kulovac/tuner-pedal/README.md

# Tuner Pedal

A tuner pedal project using an STM32 microcontroller with the CMSIS-DSP library
