kulovac/tuner-pedal/pcb/components/3dmodels/pcm1802.step

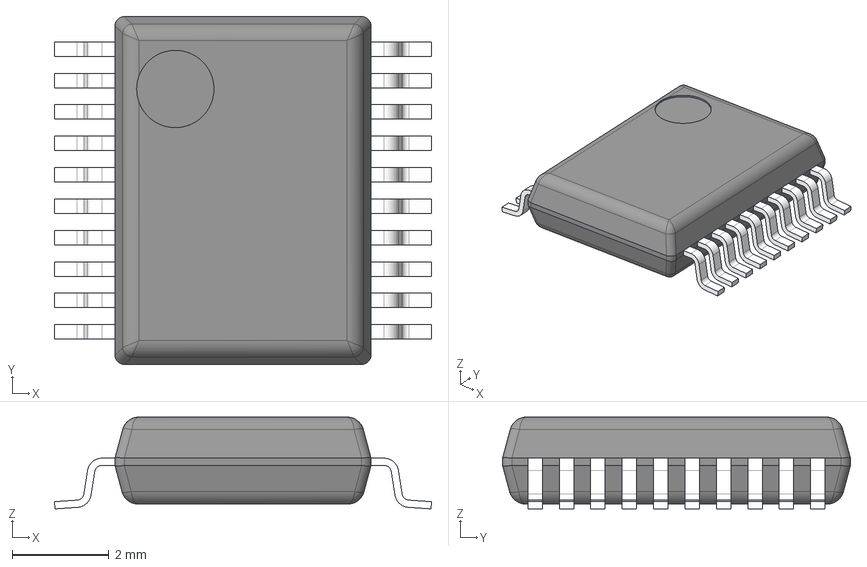
[picture p1: CAD file, 2025-06-20]
pcb/components/3dmodels/pcm1802.step
7.80 x 7.20 x 1.90 mm
BODY-SSOP
LEAD-SSOP x 20
PIN1
