kulovac/tuner-pedal/pcb/components/3dmodels/ECS-2520MVLC-081.92-BN-TR.step

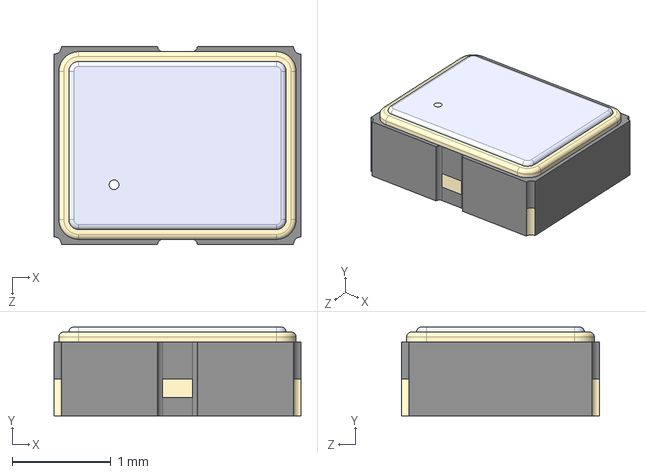
[picture p2: CAD file, 2025-06-20]
pcb/components/3dmodels/ECS-2520MVLC-081.92-BN-TR.step
2.50 x 0.9 x 2.00 mm
