kulovac/tuner-pedal/pcb/tuner_pedal.kicad_pcb

## KiCad design pcb/tuner_pedal.kicad_pcb (2025-07-28)

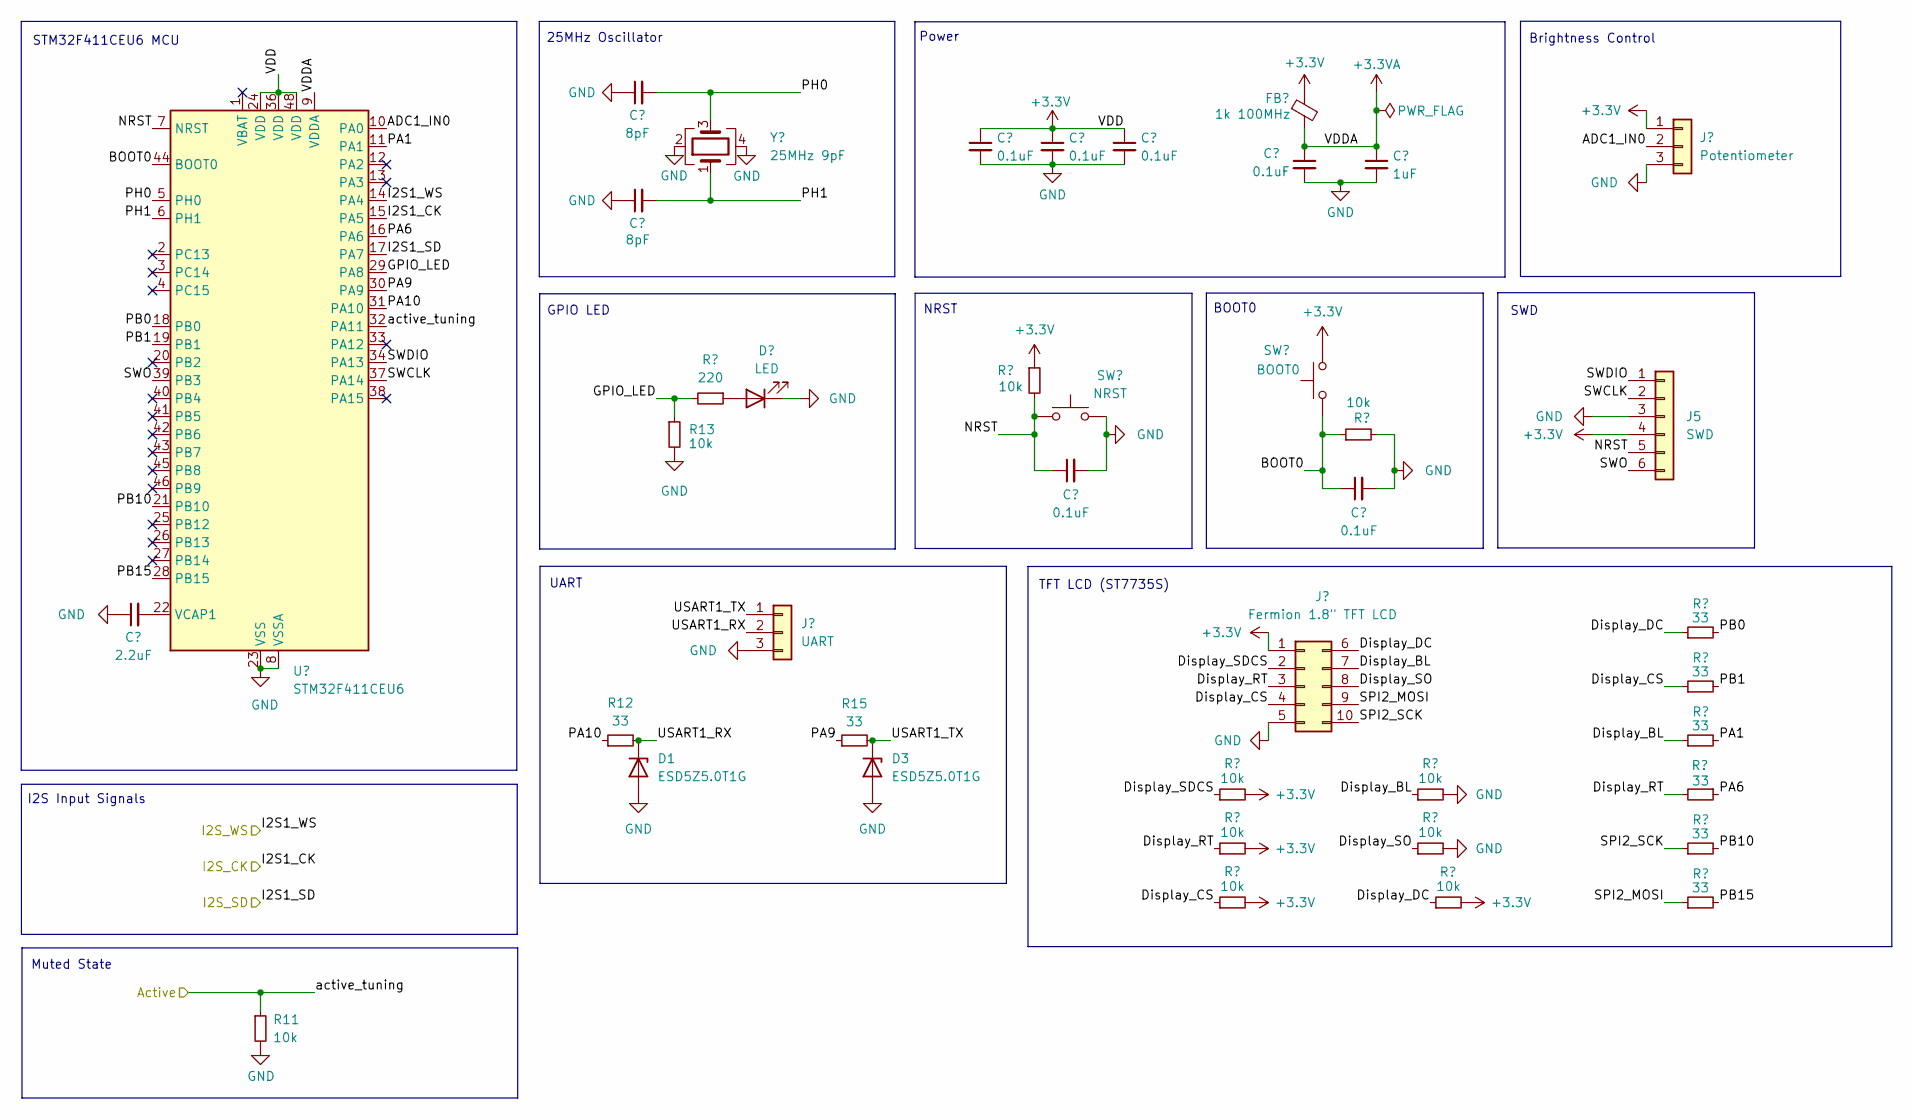
[picture p3: schematic mcu.kicad_sch]

Parts:
C22: 2.2uF; C_0805_2012Metric; MPN CL21B225KAFNNNE; LCSC C19110
C23, C24: 8pF; C_0402_1005Metric; MPN 0402CG8R0C500NT; LCSC C1578
C25, C26, C27, C28, C29, C30: 0.1uF; C_0402_1005Metric; MPN CL05B104KO5NNNC; LCSC C1525
C31: 1uF; C_0805_2012Metric; MPN CL21B105KAFNFNE; LCSC C1712
D1, D3: ESD5Z5.0T1G; D_SOD-523; MPN ESD5Z5.0T1G; LCSC C82044
D2: LED; LED_0603_1608Metric; MPN KT-0603R; LCSC C2286
FB1: 1k 100MHz; L_1806_4516Metric; MPN BLM41PG102SN1L; LCSC C88999
J3: UART; PinSocket_1x03_P2.54mm_Vertical
J4: Fermion 1.8" TFT LCD; PinHeader_2x05_P2.54mm_Vertical
J5: SWD; PinHeader_1x06_P2.54mm_Vertical
J6: Potentiometer; PinSocket_1x03_P2.54mm_Vertical
R11, R13, R16, R17, R18, R19, R20, R21, R22, R23: 10k; R_0603_1608Metric; MPN RC0603FR-0710KL; LCSC C98220
R12, R15, R24, R25, R26, R27, R28, R29: 33; R_0603_1608Metric; MPN RC0603FR-0733RL; LCSC C108661
R14: 220; R_0603_1608Metric; MPN RC0603FR-07220RL; LCSC C107696
SW1: NRST; SW_Push_1P1T_NO_6x6mm_H9.5mm; MPN TL3301AF160QG; LCSC C273519
SW2: BOOT0; SW_Push_1P1T_NO_6x6mm_H9.5mm; MPN TL3301AF160QG; LCSC C273519
U4: STM32F411CEU6; QFN-48-1EP_7x7mm_P0.5mm_EP5.6x5.6mm; MPN STM32F411CEU6; LCSC C60420
Y1: 25MHz 9pF; Crystal_SMD_3225-4Pin_3.2x2.5mm; MPN 3225-25-9-10-10/A; LCSC C2981679

Connections:
+3.3V: C25.1, C26.1, C28.1, FB1.1, J4.1, J5.4, J6.1, R16.1, R17.2, R18.2, R19.2, R23.2, SW2.2, U4.24 (VDD), U4.36 (VDD), U4.48 (VDD); also elsewhere on the board
+3.3VA: C29.1, C31.1, FB1.2, U4.9 (VDDA)
/MCU/ADC1_IN0: J6.2, U4.10 (PA0)
/MCU/BOOT0: C30.1, R20.1, SW2.1, U4.44 (BOOT0)
/MCU/Display_BL: J4.7, R21.1, R24.1
/MCU/Display_CS: J4.4, R19.1, R25.1
/MCU/Display_DC: J4.6, R23.1, R26.1
/MCU/Display_RT: J4.3, R18.1, R28.2
/MCU/Display_SDCS: J4.2, R17.1
/MCU/Display_SO: J4.8, R22.1
/MCU/GPIO_LED: R13.1, R14.2, U4.29 (PA8)
/MCU/I2S1_CK: U4.15 (PA5); also elsewhere on the board
/MCU/I2S1_SD: U4.17 (PA7); also elsewhere on the board
/MCU/I2S1_WS: U4.14 (PA4); also elsewhere on the board
/MCU/NRST: C27.1, J5.5, R16.2, SW1.1, U4.7 (NRST)
/MCU/PA1: R24.2, U4.11 (PA1)
/MCU/PA6: R28.1, U4.16 (PA6)
/MCU/PA9: R15.1, U4.30 (PA9)
/MCU/PA10: R12.1, U4.31 (PA10)
/MCU/PB0: R26.2, U4.18 (PB0)
/MCU/PB1: R25.2, U4.19 (PB1)
/MCU/PB10: R27.2, U4.21 (PB10)
/MCU/PB15: R29.2, U4.28 (PB15)
/MCU/PH0: C23.2, U4.5 (PH0), Y1.3
/MCU/PH1: C24.2, U4.6 (PH1), Y1.1
/MCU/SPI2_MOSI: J4.9, R29.1
/MCU/SPI2_SCK: J4.10, R27.1
/MCU/SWCLK: J5.2, U4.37 (PA14)
/MCU/SWDIO: J5.1, U4.34 (PA13)
/MCU/SWO: J5.6, U4.39 (PB3)
/MCU/USART1_RX: D1.1 (K), J3.2, R12.2
/MCU/USART1_TX: D3.1 (K), J3.1, R15.2
/MCU/active_tuning: R11.1, U4.32 (PA11); also elsewhere on the board
GND: C22.1, C23.1, C24.1, C25.2, C26.2, C27.2, C28.2, C29.2, C30.2, C31.2, D1.2 (A), D2.1 (K), D3.2 (A), J3.3, J4.5, J5.3, J6.3, R11.2, R13.2, R20.2, R21.2, R22.2, SW1.2, U4.8 (VSSA), U4.23 (VSS), U4.35 (VSS), U4.47 (VSS), U4.49 (VSS), Y1.2, Y1.4; also elsewhere on the board
unnamed: D2.2 (A), R14.1
unnamed: C22.2, U4.22 (VCAP1)

Notes on the sheet:
BOOT0
Muted State
NRST
TFT LCD (ST7735S)
GPIO LED
25MHz Oscillator
STM32F411CEU6 MCU
UART
SWD
Brightness Control
Power
I2S Input Signals

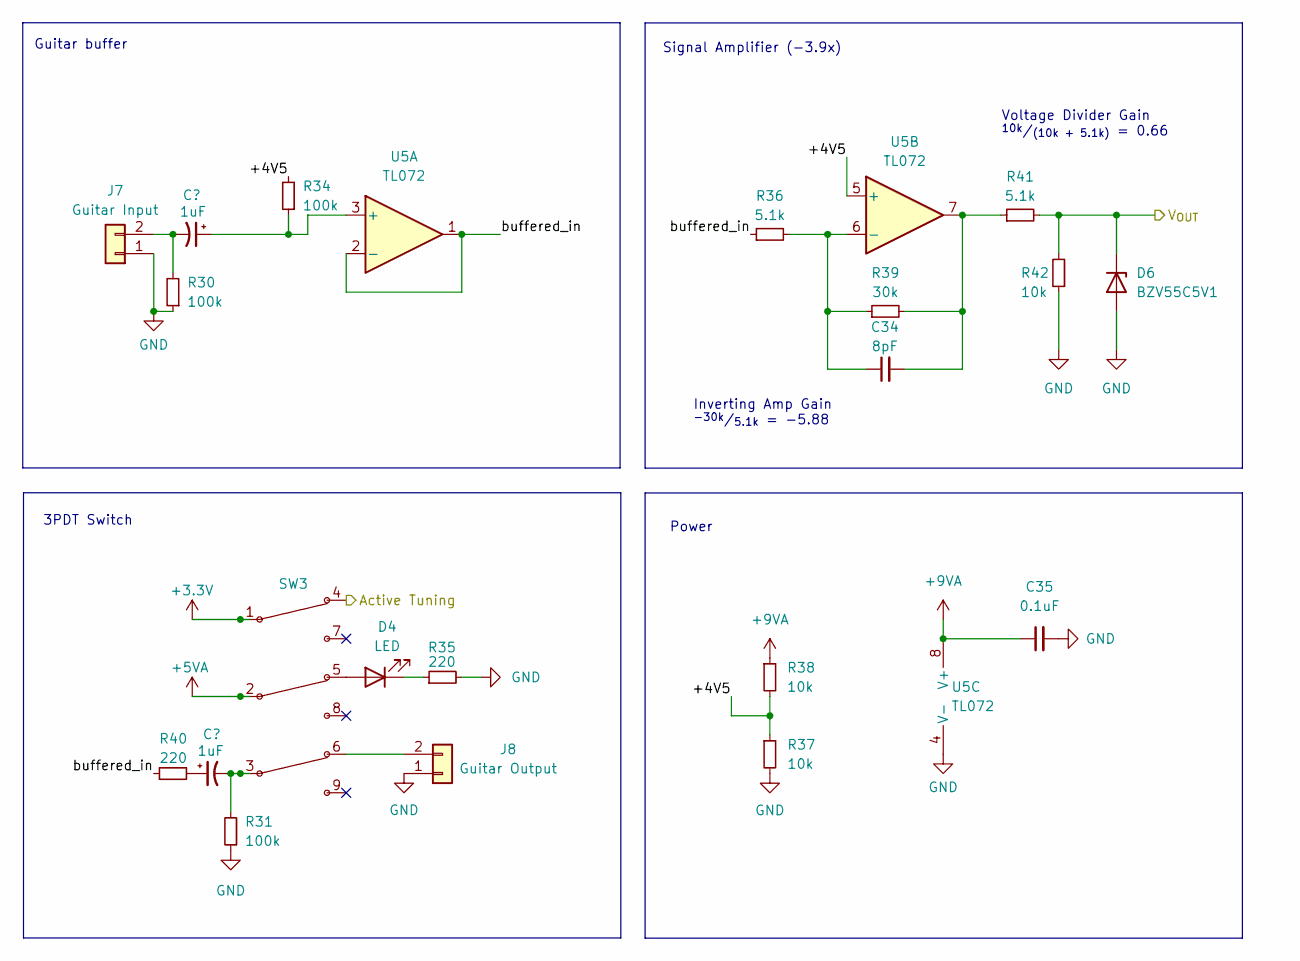
[picture p4: schematic analog_in.kicad_sch]

Parts:
C32, C33: 1uF; C_0805_2012Metric; MPN CL21B105KAFNFNE; LCSC C1712
C34: 8pF; C_0402_1005Metric; MPN 0402CG8R0C500NT; LCSC C1578
C35: 0.1uF; C_0402_1005Metric; MPN CL05B104KO5NNNC; LCSC C1525
D4: LED; PinHeader_1x02_P2.54mm_Vertical
D6: BZV55C5V1; D_MiniMELF; MPN BZV55B5V1; LCSC C545327
J7: Guitar Input; PinSocket_1x02_P2.54mm_Vertical
J8: Guitar Output; PinSocket_1x02_P2.54mm_Vertical
R30, R31, R34: 100k; R_0603_1608Metric; MPN RC0603FR-07100KL; LCSC C14675
R35, R40: 220; R_0603_1608Metric; MPN RC0603FR-07220RL; LCSC C107696
R36: 5.1k; R_Axial_DIN0207_L6.3mm_D2.5mm_P7.62mm_Horizontal; MPN MFR-25FTE52-5K1; LCSC C173033
R37, R38, R42: 10k; R_0603_1608Metric; MPN RC0603FR-0710KL; LCSC C98220
R39: 30k; R_Axial_DIN0207_L6.3mm_D2.5mm_P7.62mm_Horizontal; MPN MFR-25FTE52-30K; LCSC C173003
R41: 5.1k; R_0603_1608Metric; MPN RC0603FR-075K1L; LCSC C105580
SW3: PinHeader_2x03_P2.54mm_Vertical
U5: TL072; DIP-8_W7.62mm_Socket

Connections:
+3.3V: SW3.1; also elsewhere on the board
+5VA: SW3.2; also elsewhere on the board
+9VA: C35.1, R38.1, U5.8 (V+); also elsewhere on the board
/ADC/V_{IN}: D6.1 (K), R41.2, R42.2; also elsewhere on the board
/Analog Signal/+4V5: R34.2, R37.1, R38.2, U5.5 (+); also elsewhere on the board
/Analog Signal/buffered_in: R36.1, R40.1, U5.1, U5.2 (-)
/MCU/active_tuning: SW3.4; also elsewhere on the board
GND: C35.2, D6.2 (A), J7.1, J8.1, R30.1, R31.1, R35.2, R37.2, R42.1, U5.4 (V-); also elsewhere on the board
unnamed: C33.1, R40.2
unnamed: C33.2, R31.2, SW3.3
unnamed: C34.2, R39.2, R41.1, U5.7
unnamed: D4.2 (A), SW3.5
unnamed: D4.1 (K), R35.1
unnamed: C32.2, J7.2, R30.2
unnamed: J8.2, SW3.6
unnamed: C32.1, R34.1, U5.3 (+)
unnamed: C34.1, R36.2, R39.1, U5.6 (-)

Notes on the sheet:
Power
3PDT Switch
Inverting Amp Gain ^{-30k}/_{5.1k} = -5.88
Voltage Divider Gain ^{10k}/_{(10k + 5.1k)} = 0.66
Guitar buffer
Signal Amplifier (-3.9x)

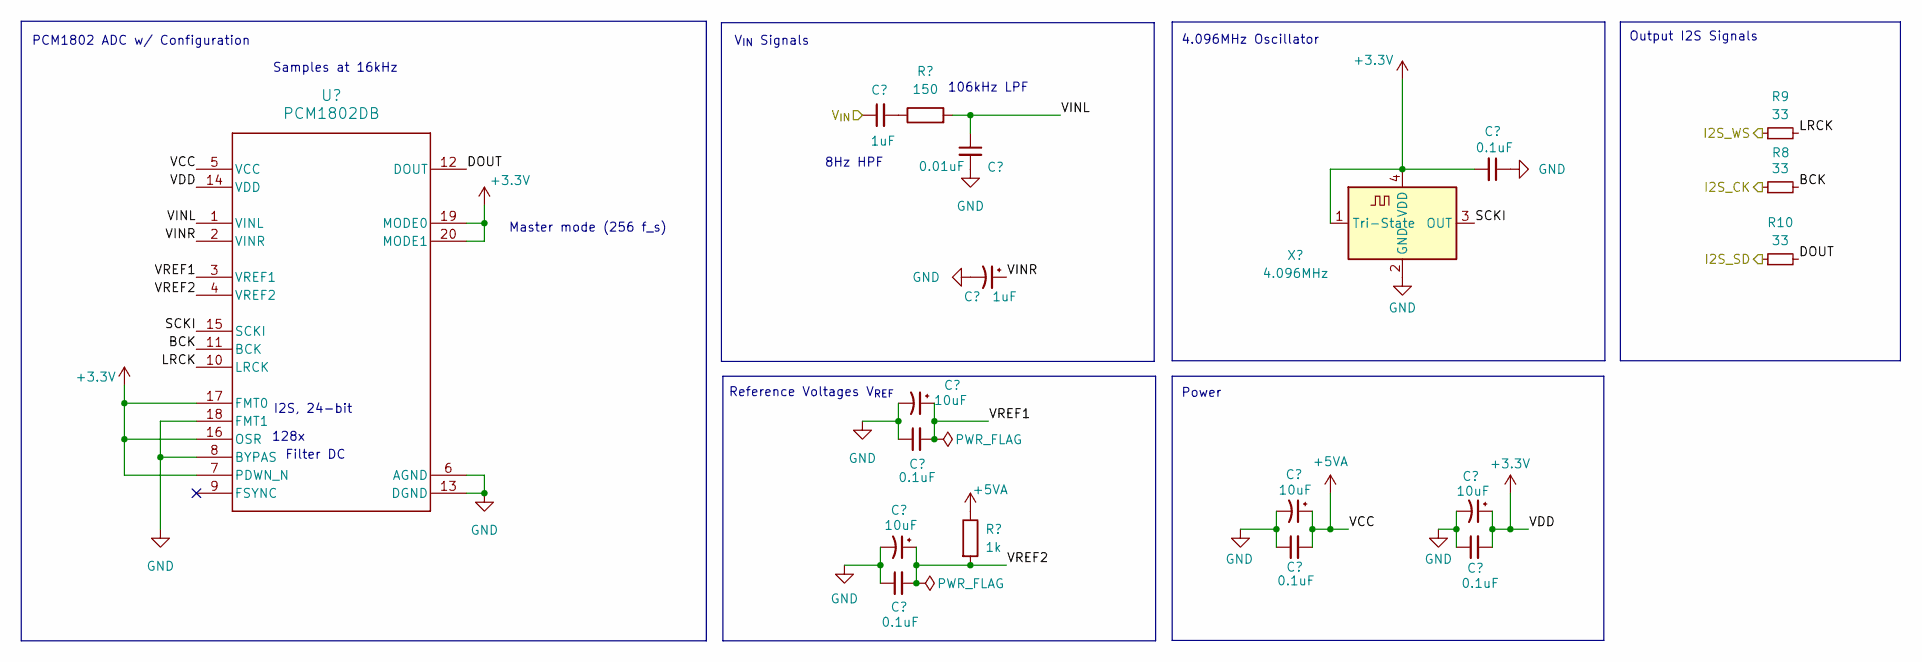
[picture p5: schematic adc.kicad_sch]

Parts:
C10, C16: 1uF; C_0805_2012Metric; MPN CL21B105KAFNFNE; LCSC C1712
C11, C13, C17, C20: 10uF; CP_EIA-3216-18_Kemet-A; MPN TAJA106K010RNJ; LCSC C7177
C12, C14, C18, C19, C21: 0.1uF; C_0402_1005Metric; MPN CL05B104KO5NNNC; LCSC C1525
C15: 0.01uF; C_0603_1608Metric; MPN CL10C100JB8NNNC; LCSC C1634
R6: 150; R_0603_1608Metric; MPN RC0603FR-07150RL; LCSC C114608
R7: 1k; R_0603_1608Metric; MPN RC0603JR-071KL; LCSC C14676
R8, R9, R10: 33; R_0603_1608Metric; MPN RC0603FR-0733RL; LCSC C108661
U3: PCM1802DB; SSOP-20_5.3x7.2mm_P0.65mm; MPN PCM1802DB; LCSC C1520787
X1: 4.096MHz; Crystal_SMD_3225-4Pin_3.2x2.5mm; MPN OT32254.096MJBA4SL; LCSC C2831395

Connections:
+3.3V: C19.2, C20.1, C21.2, U3.7 (PDWN_N), U3.14 (VDD), U3.16 (OSR), U3.17 (FMT0), U3.19 (MODE0), U3.20 (MODE1), X1.1 (Tri-State), X1.4 (VDD); also elsewhere on the board
+5VA: C17.1, C18.2, R7.1, U3.5 (VCC); also elsewhere on the board
/ADC/BCK: R8.2, U3.11 (BCK)
/ADC/DOUT: R10.2, U3.12 (DOUT)
/ADC/LRCK: R9.2, U3.10 (LRCK)
/ADC/SCKI: U3.15 (SCKI), X1.3 (OUT)
/ADC/VINL: C15.1, R6.2, U3.1 (VINL)
/ADC/VINR: C16.1, U3.2 (VINR)
/ADC/VREF1: C13.1, C14.2, U3.3 (VREF1)
/ADC/VREF2: C11.1, C12.2, R7.2, U3.4 (VREF2)
/ADC/V_{IN}: C10.1; also elsewhere on the board
/MCU/I2S1_CK: R8.1; also elsewhere on the board
/MCU/I2S1_SD: R10.1; also elsewhere on the board
/MCU/I2S1_WS: R9.1; also elsewhere on the board
GND: C11.2, C12.1, C13.2, C14.1, C15.2, C16.2, C17.2, C18.1, C19.1, C20.2, C21.1, U3.6 (AGND), U3.8 (BYPAS), U3.13 (DGND), U3.18 (FMT1), X1.2 (GND); also elsewhere on the board
unnamed: C10.2, R6.1

Notes on the sheet:
I2S, 24-bit
Master mode (256 f_s)
4.096MHz Oscillator
PCM1802 ADC w/ Configuration
Output I2S Signals
Reference Voltages V_{REF}
Samples at 16kHz
8Hz HPF
Filter DC
106kHz LPF
128x
Power
V_{IN} Signals

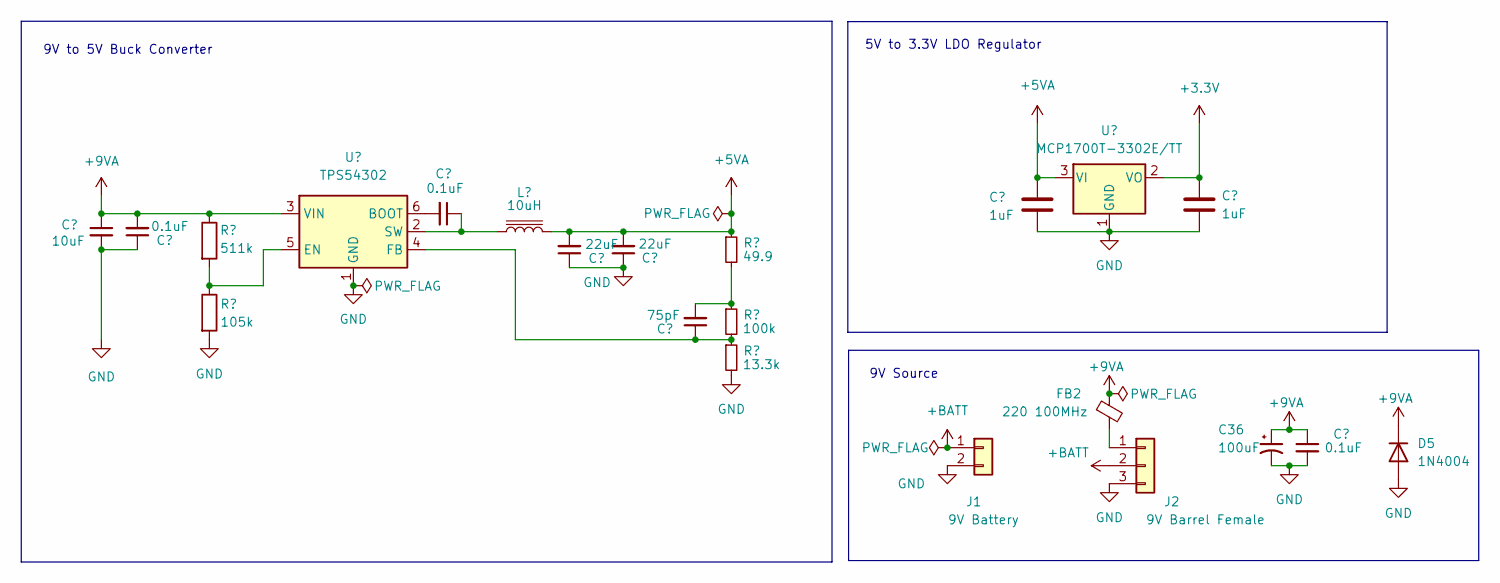
[picture p6: schematic power.kicad_sch]

Parts:
C1: 10uF; C_1206_3216Metric; MPN CC1206KKX7R8BB106; LCSC C70462
C2, C3, C9: 0.1uF; C_0402_1005Metric; MPN CL05B104KO5NNNC; LCSC C1525
C4, C5: 22uF; C_1206_3216Metric; MPN GRM31CR71A226KE15L; LCSC C91604
C6: 75pF; C_0402_1005Metric; MPN CC0402JRNPO9BN750; LCSC C107010
C7, C8: 1uF; C_0805_2012Metric; MPN CL21B105KAFNFNE; LCSC C1712
C36: 100uF; CP_Elec_6.3x5.4; MPN RVT100UF16V67RV0016; LCSC C2887276
D5: 1N4004; D_DO-41_SOD81_P10.16mm_Horizontal; MPN 1N4004; LCSC C3058
FB2: 220 100MHz; L_0603_1608Metric; MPN BLM18PG221SN1D; LCSC C80165
J1: 9V Battery; PinSocket_1x02_P2.54mm_Vertical
J2: 9V Barrel Female; PinHeader_1x03_P2.54mm_Vertical
L1: 10uH; L_6.3x6.3_H3; MPN PNLS6045-100M 10UH; LCSC C2849537
R1: 511k; R_0603_1608Metric; MPN RC0603FR-07511KL; LCSC C188257
R2: 105k; R_0603_1608Metric; MPN RC0603FR-07105KL; LCSC C141685
R3: 49.9; R_0603_1608Metric; MPN RC0603FR-0749R9L; LCSC C114625
R4: 100k; R_0603_1608Metric; MPN RC0603FR-07100KL; LCSC C14675
R5: 13.3k; R_0603_1608Metric; MPN RC0603FR-0713K3L; LCSC C185373
U1: TPS54302; SOT-23-6; MPN TPS54302DDCR; LCSC C311983
U2: MCP1700T-3302E/TT; SOT-23-3; MPN MCP1700T-3302E/TT; LCSC C39051

Connections:
+3.3V: C8.1, U2.2 (VO); also elsewhere on the board
+5VA: C4.2, C5.2, C7.1, L1.2, R3.1, U2.3 (VI); also elsewhere on the board
+9VA: C1.1, C2.2, C9.1, C36.1, D5.1 (K), FB2.1, R1.1, U1.3 (VIN); also elsewhere on the board
+BATT: J1.1, J2.2
GND: C1.2, C2.1, C4.1, C5.1, C7.2, C8.2, C9.2, C36.2, D5.2 (A), J1.2, J2.3, R2.2, R5.2, U1.1 (GND), U2.1 (GND); also elsewhere on the board
unnamed: C6.2, R3.2, R4.1
unnamed: FB2.2, J2.1
unnamed: C3.2, U1.6 (BOOT)
unnamed: R1.2, R2.1, U1.5 (EN)
unnamed: C6.1, R4.2, R5.1, U1.4 (FB)
unnamed: C3.1, L1.1, U1.2 (SW)

Notes on the sheet:
9V Source
5V to 3.3V LDO Regulator
9V to 5V Buck Converter

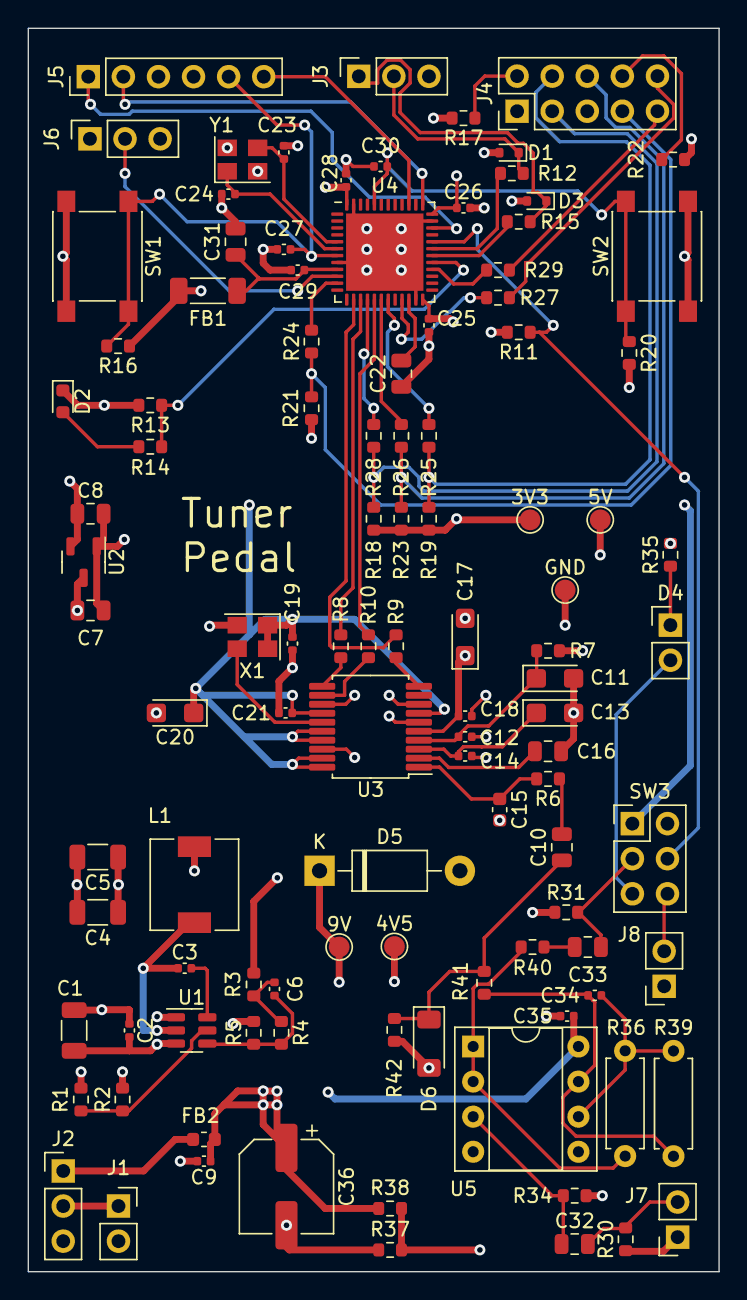
[picture p7: board tuner_pedal.kicad_pcb from above]

Board: 4 copper layers, 50.0 x 90.0 mm, 108 parts (0 on the bottom side), 66 nets.

Other parts of the board:
3V3, 4V5, 5V, 9V: TestPoint_Pad_D1.5mm
GND: TestPoint_Pad_D1.5mm

Their connections:
+3.3V: 3V3.1; also elsewhere on the board
+5VA: 5V.1; also elsewhere on the board
+9VA: 9V.1; also elsewhere on the board
/Analog Signal/+4V5: 4V5.1; also elsewhere on the board
GND: GND.1; also elsewhere on the board
