kulovac/tuner-pedal/firmware/src/log.c

#include "log.h"
#include "bsp.h"
#include "stm32f4xx_ll_bus.h"
#include "stm32f4xx_ll_gpio.h"
#include "stm32f4xx_ll_usart.h"
#include <stdarg.h>
#include <stdio.h>

#if LOG_LEVEL != LOG_LEVEL_NONE

static void usart_puts(const char *);

void init_logger(void) {
    LL_APB2_GRP1_EnableClock(LL_APB2_GRP1_PERIPH_USART1);

    LL_GPIO_InitTypeDef tx_pin = {.Pin = LOGGER_TX_PIN,
                                  .Mode = LL_GPIO_MODE_ALTERNATE,
                                  .Speed = LL_GPIO_SPEED_FREQ_HIGH,
                                  .OutputType = LL_GPIO_OUTPUT_PUSHPULL,
                                  .Pull = LL_GPIO_PULL_UP,
                                  .Alternate = LOGGER_TX_AF};
    LL_GPIO_Init(LOGGER_TX_PORT, &tx_pin);

    LL_USART_InitTypeDef logger = {.BaudRate = 115200,
                                   .DataWidth = LL_USART_DATAWIDTH_8B,
                                   .StopBits = LL_USART_STOPBITS_1,
                                   .Parity = LL_USART_PARITY_NONE,
                                   .TransferDirection = LL_USART_DIRECTION_TX,
                                   .HardwareFlowControl =
                                       LL_USART_HWCONTROL_NONE,
                                   .OverSampling = LL_USART_OVERSAMPLING_8};

    LL_USART_Init(LOGGER_USART, &logger);
    LL_USART_Enable(LOGGER_USART);
}

void usart_printf(const char *str, ...) {
    char formatted[LOG_BUFFER_SIZE];
    va_list args;

    va_start(args, str);
    vsnprintf(formatted, LOG_BUFFER_SIZE, str, args);
    va_end(args);

    usart_puts(formatted);
}

static void usart_puts(const char *str) {
    while (*str != '\0') {
        while (!LL_USART_IsActiveFlag_TXE(LOGGER_USART))
            ;
        LL_USART_TransmitData8(LOGGER_USART, *str++);
    }
}

#endif
