kulovac/tuner-pedal/(commit log)

2025-06-20 Updated gitignore for KiCAD
    [ABLS-8.192MHZ-B2-T.step, ECS-2520MVLC-081.92-BN-TR.step, pcm1802.step]
2025-06-20 Starting tuner pedal schematic with ADC
    [tuner_pedal.kicad_pcb, tuner_pedal.kicad_sch]
2025-06-20 Added 5->3.3V LDO
    [tuner_pedal.kicad_sch]
2025-06-20 Added 9V->5V buck converter
    [tuner_pedal.kicad_sch]
2025-06-20 added githubs gitignore for kicad
2025-06-20 added AC coupling cap to unused V_inR
    [tuner_pedal.kicad_sch]
2025-06-20 Added crystal oscillators to stm32
    [tuner_pedal.kicad_sch]
2025-06-20 Deleted unused component
    [ABLS-8.192MHZ-B2-T.step]
2025-06-20 Removed RTC crystal
    [tuner_pedal.kicad_sch]
2025-06-20 Connected stm32 to 3V3
    [tuner_pedal.kicad_sch]
2025-06-20 Added SWD header
    [tuner_pedal.kicad_sch]
2025-06-20 Defined which pins will be used on the stm32
    [tuner_pedal.kicad_sch]
2025-06-20 Defined headers for each interface
    [tuner_pedal.kicad_sch]
2025-06-21 Added GPIO attached LED for debugging purposes
    [tuner_pedal.kicad_sch]
2025-06-21 Made FSYNC floating
    [tuner_pedal.kicad_sch]
2025-06-21 Added NRST and BOOT0 buttons
    [tuner_pedal.kicad_sch]
2025-06-21 Added pull-ups/downs and series termination to LCD
    [tuner_pedal.kicad_sch]
2025-06-23 Added pot pins
    [tuner_pedal.kicad_sch]
2025-06-23 Created a power sheet
    [power.kicad_sch, tuner_pedal.kicad_sch]
2025-06-23 Added filtering cap to 9V barrel
    [power.kicad_sch]
2025-06-24 Removed power hierarchy labels
    [power.kicad_sch]
2025-06-24 Made sheet for ADC
    [adc.kicad_sch, tuner_pedal.kicad_sch]
2025-06-24 Made MCU sheet
    [mcu.kicad_sch, tuner_pedal.kicad_sch]
2025-06-24 Connected SWO pin
    [mcu.kicad_sch]
2025-06-25 Changed the LPF to 106 kHz cutoff
    [adc.kicad_sch]
2025-06-27 Created 3PDT footswitch schematic symbol
2025-06-27 Created analog frontend
    [analog_in.kicad_sch]
2025-06-27 Changed cap to nonpolarized to account for analog_in biasing scheme
    [adc.kicad_sch]
2025-06-27 Added input GPIO to check muted state
    [mcu.kicad_sch]
2025-06-27 Brought in analog frontend
    [tuner_pedal.kicad_sch]
2025-06-27 Fixed I/O direction on hierarchy labels
    [adc.kicad_sch, analog_in.kicad_sch, mcu.kicad_sch, tuner_pedal.kicad_sch]
2025-06-27 Reordered components
    [adc.kicad_sch, analog_in.kicad_sch, mcu.kicad_sch, power.kicad_sch]
2025-06-27 Connected VDD cap to GND
    [adc.kicad_sch]
2025-06-27 actually connect net
    [analog_in.kicad_sch]
2025-06-27 Adding safety to output jack signal path
    [analog_in.kicad_sch]
2025-06-27 Attached backlight to timer capable pin
    [mcu.kicad_sch]
2025-06-28 Assigned footprints and jlcpcb part number to all components
    [adc.kicad_sch, analog_in.kicad_sch, mcu.kicad_sch, power.kicad_sch]
2025-06-29 Added correct datasheet to pcm1802 symbol
    [adc.kicad_sch]
2025-06-29 Changed 10k inverting amp resistor to THT for easy swapping
    [analog_in.kicad_sch]
2025-06-29 Changed op amp supply to 9V to make sure clipping doesn't occur
    [analog_in.kicad_sch]
2025-06-29 Added better filtering for 9V supply
    [power.kicad_sch]
2025-06-29 ERC fixes
    [adc.kicad_sch, analog_in.kicad_sch, mcu.kicad_sch, power.kicad_sch, tuner_pedal.kicad_sch]
2025-06-29 Starting PCB layout
    [adc.kicad_sch, analog_in.kicad_sch, mcu.kicad_sch, power.kicad_sch, tuner_pedal.kicad_pcb]
2025-06-30 Added Analog in signal and 9V to 5V buck converter
    [analog_in.kicad_sch, power.kicad_sch, tuner_pedal.kicad_pcb]
2025-07-01 First revision of the pcb layout
    [adc.kicad_sch, analog_in.kicad_sch, mcu.kicad_sch, power.kicad_sch, tuner_pedal.kicad_pcb]
2025-07-02 trying to isolate analog from noise sources
    [analog_in.kicad_sch, tuner_pedal.kicad_pcb]
2025-07-02 Moved LED to make soldering a bit easier
    [tuner_pedal.kicad_pcb]
2025-07-11 Updated gitignore for C and STM32
2025-07-11 cloned 'https://github.com/ARM-software/CMSIS-DSP.git'
2025-07-28 Lowered resistor values and added protection diode
    [analog_in.kicad_sch, power.kicad_sch, tuner_pedal.kicad_pcb]
2026-07-12 Basic uart logging for dev work
2026-07-12 Setup stm32f4 driver boilerplate
2026-07-12 led on!
2026-07-12 now a blinking led!
2026-07-12 Basic uart test
2026-07-12 uart based logger
2026-07-25 Added initialization for i2s device (pre dma)
2026-07-25 Enable I2S device
2026-07-25 One shot test getting 512 L and R samples
2026-07-25 add missing `const` modifier
    [dsp.c]
2026-08-08 Setup DMA to be used with the display
2026-08-08 Display no longer bottlenecks the system
    [main.c]
2026-08-08 Fix little/big endian mismatch
    [gfx.h]
2026-08-08 Increase spi clock speed by 128x
2026-08-08 Fix release mode display bug
    [dsp.c, tft.c]
2026-08-21 Clean up bsp_init into helpers & init i2s dma
2026-08-21 Setup isr for i2s dma
2026-08-21 Get i2s dma transfers working
